ibosoftnet/efis/EEEN_102_Final_Report.pdf

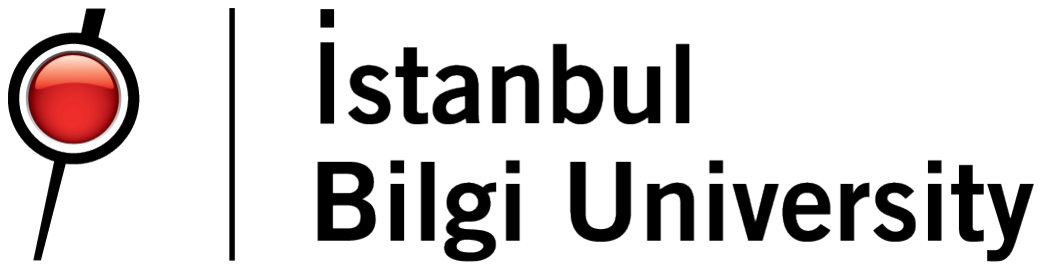
[picture p1: figure]

# Electronic Flight Instrument System (EFIS)

EEEN 102 Embedded Systems Programming Final Project

## İbrahim Çağlar YILDIRIM

June 19, 2024

## Contents

1 Introduction | 2
2 Air Data Unit Hardware | 3
2.3.2 Considerations Regarding the Design of the Circuit . . | 4
3 Air Data Unit MCU Software | 9
4 EFIS Display Software | 9
5 Abbreviations | 15
5.3.1 | ICAO Measurement Units and Quantity Symbols . . . . | 16
6 References | 17

1

## 1 Introduction

Main idea of the project is developing a fully real aviation compilant flight man-agament / navigation system and electronic flight instrument system (EFIS) for RC airplanes or UAVs. Because currently end user UAV flight controller kits are boring and they have missing features which used in real airplanes. Currently Air Data Unit and Display Software for ground station is developed. Radio navigation unit, flight management system and auto-flight systems will be developed in future.
This document includes these parts of project:
- Air Data Unit (v1.1)
- Air Data Unit MCU Software (v0.1)
- EFIS Display Software (v0.1.1)

All project files can be found at project’s GitHub page: https://github.com/ibosoftnet/efis

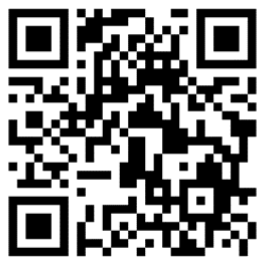
[picture p2: figure]

2

## 2 Air Data Unit Hardware

### 2.1 Introduction

Main hardware called as "Air Data Unit" and it reads sensor data and sends the calculated air data to UART output. Air Data Unit consists of a outer case and a electronic board.
Outer case consist of a case and cover, cover has required holes for allowing to making connections to electronic board.
Electronic board is holds all circuit elements and main MCU for operating the Air Data Unit.

### 2.2 Features and Limitations

- Supply voltage range: 7.5 – 25 V.
- High voltage protection by varistors.
- Low voltage protection by MCU brownout detection.
- Separated supply lines for board and external devices.
- Max 100 mA for main board and max 500 mA for external outputs.
- 100 mA PTC fuses on each power out.
- All I/O pins (except SPI) has serial current limiting resistors.
- ATMega 328P MCU @ 20 MHz
- RTC chip for date and time keeping.
- CR1220 battery for RTC chip.
- Separated I²C lines via switch for isolating lines from each other when corruption occurs on some of lines.
- Main UART for data transmission and secondary UART for GNSS mod-ule.
- UART1 can capable up to 230400 bauds and has flow control pins.
- UART2 can capable up to 38400 bauds.
- SPI port (6 pins AVR ISP).
- 6 configurable general purpose I/O or analog inputs.

3

### 2.3 Electronic Board

### 2.3.1 Circuit Schematic

1 2
X1

20MHz

C2

22pF
C1

22pF

C5

100nF

1 2

L1

~10-100uH

Ceramic

D1

1N4148 R1

10k | 2

1

4

3

SW1

TACH 6x6x4

R2

330

C14

100nF

D3

1N4148 D4

5.1V | R3
| 2.2k

PD0/RX
PD1/TX
PD2 PD3 PD4 PD5 PD6 PD7

PD0/RX

PD2

PULS RES | PULS RES

PC0/ADC0 PC1/ADC1 PC2/ADC2 PC3/ADC3 SDA

SCL

ADC6 ADC7

MISO
SCK
MOSI | SPI RES

AV BUS

PC0/ADC0

PC2/ADC2

ADC6

PB0 PB1

C4

100nF

1

1
2

2
3

3
4

### 4 J5

JST PH 4 PIN

1

1
2

2
3

3
4

### 4 J6

JST PH 4 PIN

1

1
2

2
3

3
4

### 4 J7

JST PH 4 PIN

2 | 1 2 3 4

1

3

### 4 J8

JST PH 4 PIN

1

1
2

2
3

3
4

### 4 J9

JST PH 4 PIN

1

1
2

2
3

3
4

### 4 J10

JST PH 4 PIN AV BUS

SDA

SCL

RESET 3

A0 1 | A1 2 | A2 21
GND | 12
SC0 | 5
SC1 | 7
SC2 | 9
SC3 | 11
SC4 | 14
SC5 | 16
SC6 | 18
SC7 | 20

SCL 22

SD0 | 4
SD1 | 6
SD2 | 8
SD3 | 10
SD4 | 13
SD5 | 15
SD6 | 17
SD7 | 19

SDA 23

VCC 24 U2

TCA9548APWR

+

1
- 2

B1

DS1092-15-B6P | 1 2
X2

32.768kHz

PB2

PB0 PB1

PB2 | RST 5 | SCLK 7

I/O 6

X1 | 2
X2 | 3
VCC1 8 | VCC2 1

U3

DS1302

PD6

R16

10k

R8

2.2k

D2

1N4148

RES

PB0/ICP1/CLKO/PCINT0 | 12 PB1/OC1A/PCINT1 | 13
PB3/MOSI/OC2A/PCINT3 | 15 PB2/SS/OC1B/PCINT2 | 14
PD6/AIN0/OC0A/PCINT22 10 | PD5/T1/OC0B/PCINT21 9 | PD4/T0/XCK/PCINT20 2 | PD3/INT1/OC2B/PCINT19 1 | PD2/INT0/PCINT18 32 | PD1/TXD/PCINT17 31 | PD0/RXD/PCINT16 30
PB4/MISO/PCINT4 | 16 PB5/SCK/PCINT5 | 17
PB7/TOSC2/XTAL2/PCINT7 | 8 PB6/TOSC1/XTAL1/PCINT6 | 7
PC6/RESET/PCINT14 | 29 PC5/ADC5/SCL/PCINT13 | 28 PC4/ADC4/SDA/PCINT12 | 27 PC3/ADC3/PCINT11 | 26 PC2/ADC2/PCINT10 | 25 PC1/ADC1/PCINT9 | 24 PC0/ADC0/PCINT8 | 23 AVCC 18 | AREF 20

PD7/AIN1/PCINT23 11

ADC6 19 ADC7 22

U1

ATMEGA328P

RES

RT3 +tc100mA | +tc

RT5

100mA +tc

RT6

100mA +tc

RT7

100mA +tc

RT8

100mA +tc

RT9

100mA +tc

RT10

100mA

VI 3 | VO | 1 GND

2

U4

78L05

C11

330nF | C12
| 100nF

D9

1N4007

D8

1N4007

VI 2 | VO | 3 GND

1

U5

7805 1 2

C10

47uF 25V

AV BUS

R10

2.2k

1 2
C13

47uF 16V

1

1

2

### 2 J12

JST XH 2 PIN

RT2 +tc500ma

1 2 U7:A

74HC14

R17

2.2k

D17

RED 3 mmR18

2.2k

D18

RED 3 mmR19

2.2k

D19

RED 3 mmR20

2.2k

D20

RED 3 mm

D15

RED 3 mmR22

2.2k

D16

RED 3 mm

PD0/RX 8 | 9 U6:F

74HC14
PD1/TX 10 | 11 U6:E

74HC14
PD2 4 | 3 U6:B

74HC14
PD3 6 | 5 U6:C

74HC14

PD4

PD5

4 3 U7:B

74HC14

8 9 U7:F

74HC14

10 11 U7:E

74HC14
12 13 U7:D
74HC14 | 2 1
VR2

25V

C15

100nF

C16

100nF

C7

330nF | C8
| 100nF

D7

1N4007

D6

1N4007 1 2
C6
22uF 25V | 1 2
C9

22uF 16V

1

1

2

### 2 J11

JST XH 2 PIN

RT1 +tc100mA | 2 1

VR1

25V

R4
100k | PD0/RX R5
100k | PD2

D5

1N4148 C3

100nF

RT4 +tc100mA

AV BUS

D11

GREEN 3 mm AV BUS

R9

2.2k

R29220 | R30220 R31220 | ADC7 R32220 R33220 | PC1/ADC1

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
JST PH 8 PIN

R34220 PC3/ADC3

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
JST PH 4 PIN

R23
220 R24220

PD1/TX R25

220 R26
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
JST PH 6 PIN

PD5

PD4 R27

220 R28

100k

6 5 U7:C

74HC14

R21

2.2k

2 1 U6:A

74HC14

12 13 U6:D

74HC14

C17

100nF

SCL

SDA

R6

2.2k R7

2.2k

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
IDC 2x3

MISO

SCK | MOSI SPI RES PD⁷

D10

YELLOW 3 mm

D12

GREEN 3 mm

Q1

BC857A

R11

2.2k

D13

RED 3 mm

Q2

BC857A

R14

2.2k

D14

RED 3 mm

R13

330

R12

100k SDA | SCL

R15

100k

IboSoft Air Data Unit v1.1
Web: www.ibosoft.net.tr
GitHub: ibosoftnet/EFIS

Figure 1: Circuit schematic

### 2.3.2 Considerations Regarding the Design of the Circuit

- All ICs have 100 nF ceramic de-coupling capacitors connected to supply pins.
- All communication line LEDs isolated from communication lines with NOT gates or BJT transistors for allowing the high speed communication.
- D7, D9, C7, C8, C11, C12 placed according to recommendations mentioned in various 78XX series linear voltage regulator datasheets.
- D6, and D8 prevents from reverse voltage with short circuiting and causing the trip of RT1 or RT2 PTCs.
- C6, C9, C10, C13 placed as bulk capacitor for preventing the supply voltages from dropping low during high peak loadings.
- D2 and D3 placed for protecting connected SPI device from short circuit when reset line goes low during reset output of SPI device is high.

4

- C14 placed for generating pulse reset signal for generating single reset if programmer pulls the reset pin of UART1 to low continuously.
- D3 diode prevents current wants to travel to MCU if UART1 reset line goes low and after high. Because voltage over C14 will increase in this situation. Normally, reset pin durable the higher voltages due to HVPP mode but other external devices connected to reset line may damaged if voltage exceeds the limit.
- D4, R3 and D5 placed to ensuring the discharge of C14. Otherwise, UART1 device can’t reset the MCU anymore after first reset attempt. R3 limits the discharge current for protecting the C14, D4, R3 and D5 from high peak current.
- All UART I/Os have required pull-up or pull down resistors.
- I

2C outputs haven’t got pull-up resistors because external I²C devices may have internal pull-up resistors and this may cause to excessively low equivalent pull-up resistances if pull-up resistors placed to I²C outputs. If a external I²C device hasn’t got internal pull-up resistors, external pull-up resistors must be connected to related output.

- RX and TX lines of UART2 passed through NOT gates for take advantage of inverted software serial method because it provides greater baud rates than non-inverted software serial.

Most applicable recommendations and limitations have been followed mentioned in Atmel AVR042: AVR Hardware Design Considerations guide and Microchip ATmega 328 datasheet:

- All outputs except SPI has current limiting resistors.
- All MCU supplies have 100 nF ceramic de-coupling capacitors.
- Low-pass filter created with L1 and C5 used for filtering the AVCC supply of MCU.
- R2 placed for limiting peak voltage induced by self-inductance of SW1 button.
- External pull-up resistor (R1) placed for guaranteeing high state at reset input.
- D1 placed for ESD protection because reset pin hasn’t got internal ESD protection diodes due tı HVPP mode of ATmega MCUs.
- 22 pF ceramic capacitors used for 20 MHz crystal.

5

### 2.3.3 PCB Design Rules

- SMD and TH mixed.
- 2 layers used.
- Minimum 9 Thou spacing and trace width used.
- Dimensions are 42 mm × 82 mm.
- Screw holes are M3.

### 2.3.4 Images of PCB

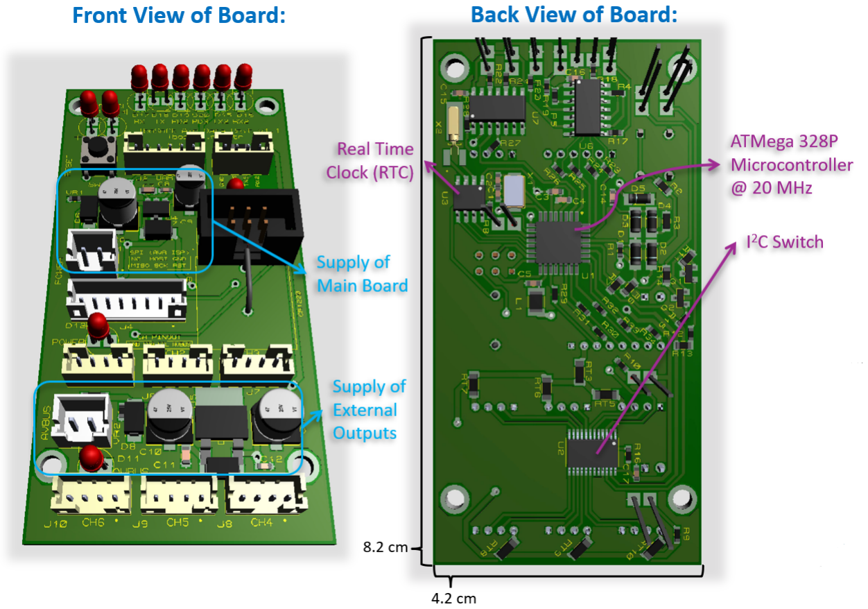
[picture p3: figure]

Figure 2: Front and back view of PCB

6

### 2.3.5 Block Diagram

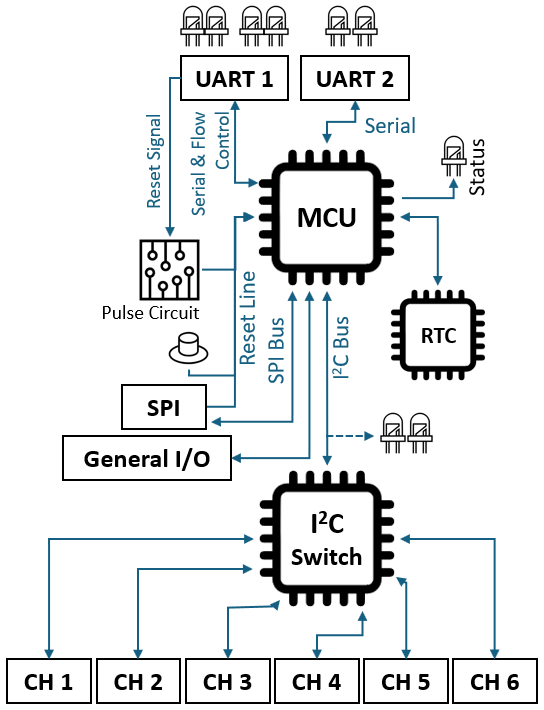
[picture p4: figure]

Figure 3: Block diagram of electronic board.

### 2.4 Entire Unit

### 2.4.1 Images of Unit

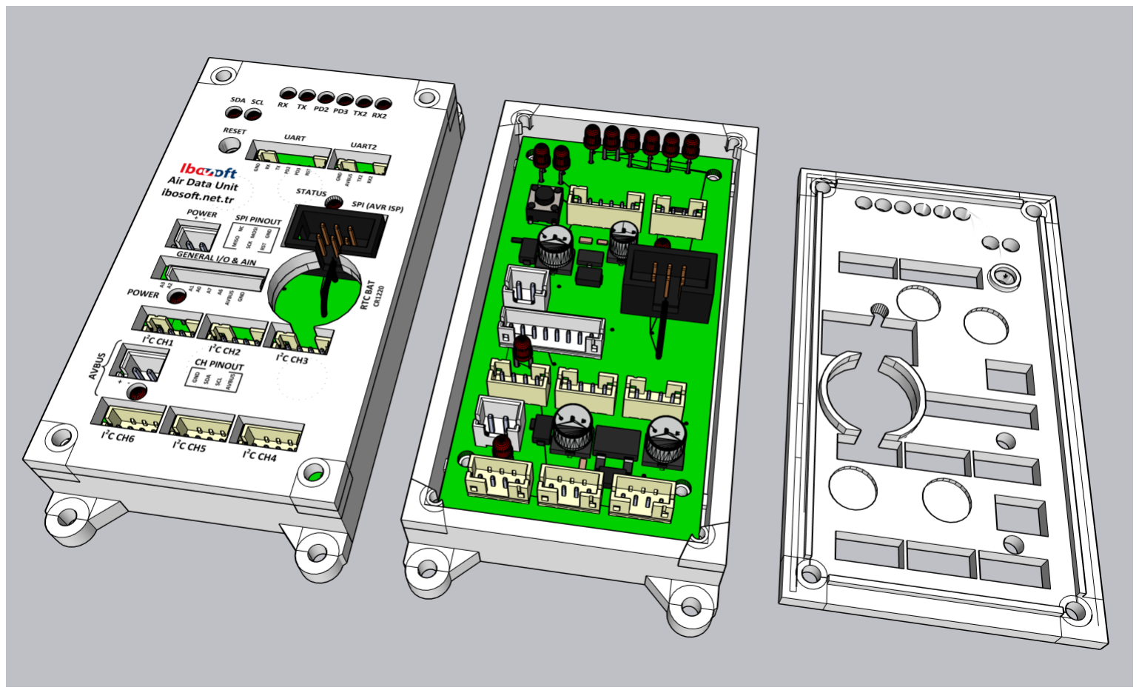
[picture p5: figure]

Figure 4: Images of inside and outside of case.

7

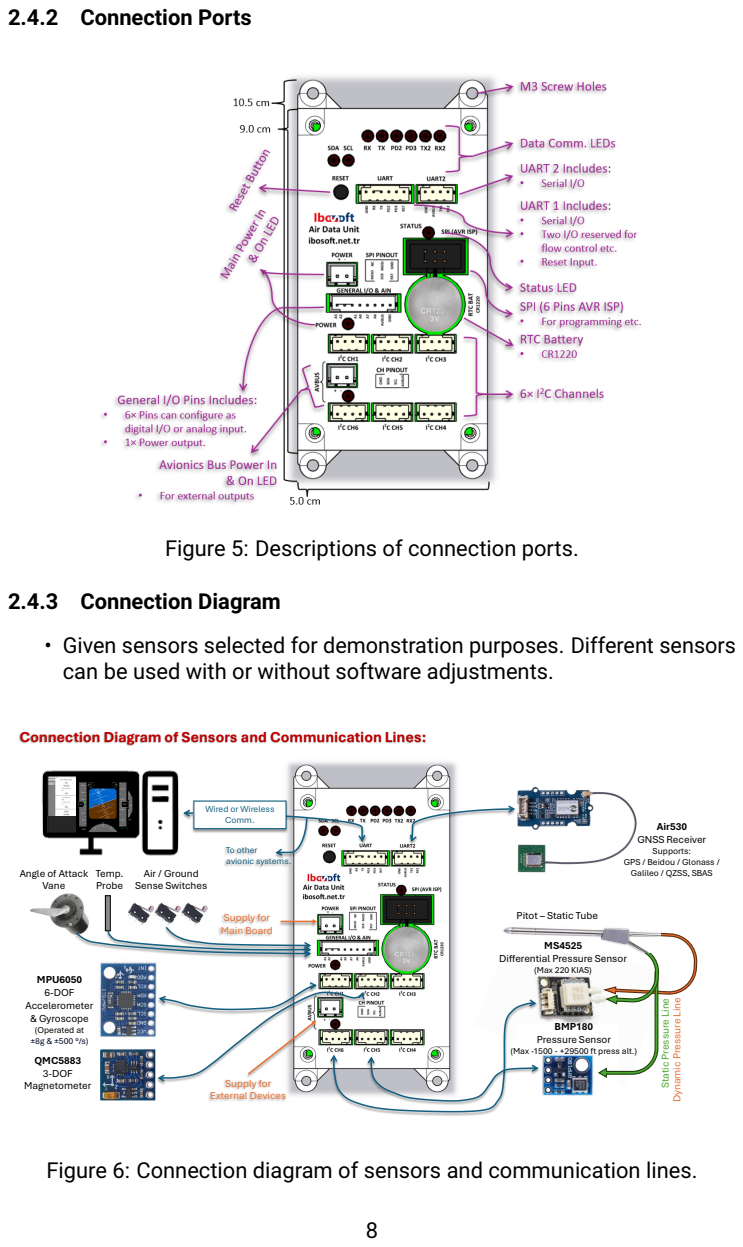
[picture p6: page 9]
2.4.2 Connection Ports; 2.4.3 Connection Diagram; Supply for Main Board; Supply for External Devices; Temp. Probe; Air / Ground Sense Switches; MPU6050 6-DOF Accelerometer & Gyroscope (Operated at ±8g & ±500 °/s) QMC5883 3-DOF Magnetometer; (Max 220 KIAS); To other avionic systems.

Figure 5: Descriptions of connection ports.

• Given sensors selected for demonstration purposes. Different sensors
can be used with or without software adjustments.

Connection Diagram of Sensors and Communication Lines:

Wired or Wireless
Comm.

Air530
GNSS Receiver
Supports:
GPS / Beidou / Glonass /
Galileo / QZSS, SBAS

Angle of Attack
Vane

Pitot – Static Tube

Differential Pressure Sensor

Static Pressure Line

Dynamic Pressure Line

BMP180
Pressure Sensor
(Max -1500 - +29500 ft press alt.)

Figure 6: Connection diagram of sensors and communication lines.

## 3 Air Data Unit MCU Software

Air Data Unit MCU Software reads sensor data and calculates usable air data according to raw sensor datas and send them over UART1 serial output. GNSS data reading and parsing will be integrated in future. Air data calculation derived from ICAO Doc 7488 - Manual of The ICAO Standard Atmosphere but detailed air data calculations and software features don’t shown in this document.
C/C++ programming language used with AVR-GCC compiler. Main aim is avoiding excessive library use but we couldn’t avoid using Arduino libraries because it required by some other libraries. We will eliminate the use of some libraries in the future.
An external header file that stores only the variables was created so that adjustments could be made without editing the main code.

## 4 EFIS Display Software

### 4.1 Introduction

EFIS Display Software used for displaying air data and sending commands to Air Data Unit via serial port. Python programming language was used. Display software decodes incoming serial data and shows air data symbology according to incoming data and it capable to show failure flags for related air data if sensor failure sended in incoming data. Also Display Software can capable to detect communication lost. Currently, only primary flight display (PFD) completed, other displays will be developed in future.
Also it provides a control menu for adjusting some settings and sends to changed data to Air Data Unit in every data cycle. "Tkinter" library used for control menu.
Symbology displaying with "Pygame" library. Some symbologies are code-based, while others are created by projecting image files onto the screen. Mathematical algorithms used for positioning the symbols doesn’t explained in this document.
Boeing-style symbology was used due to familiarity. Symbologies derived from PDF formatted Boeing 737 Flight Crew Operation Manual (FCOM). As font, original Boeing font didn’t use due to copyright issues so OCR-B font selected for displaying texts and numbers.

9

### 4.2 PFD - Normal Symbology

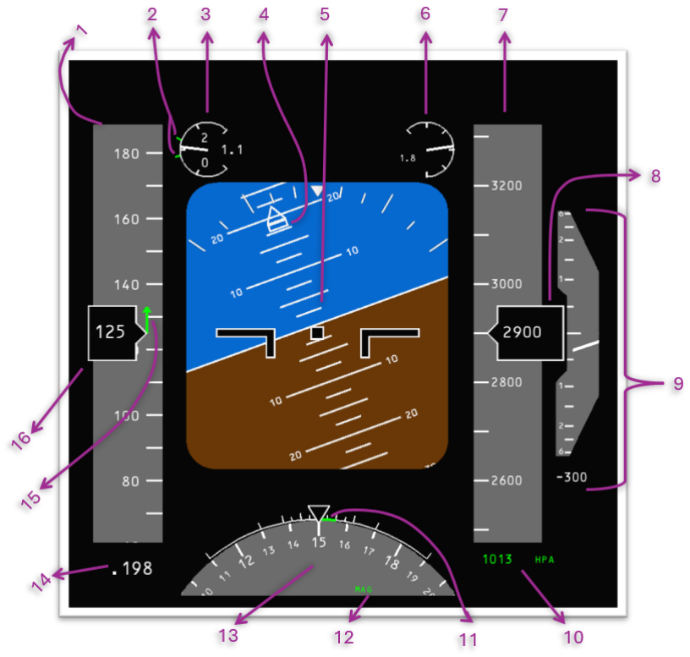
[picture p7: figure]

Figure 7: Descriptions of PFD symbology.

1. Airspeed Tape.
2. G Peaks (g): Shows minimum and maximum recorded vertical acceleration in g. Can be resetten from "G Peaks" page.
3. Vertical Acceleration Indicator: Shows vertical acceleration in g.
4. Slip / Skid Indicator: Shows lateral acceleration.
5. Attitude Indicator: Shows pitch and roll angles in degrees (°). Ticks over roll scale are equal to these values in order of: 10°, 20°, 30°, 45°, 60°.
6. Angle of Attack Indicator: Shows angle of attck in degrees (°). Single division is equal to 10°.

10

7. Altitude Tape.
8. Altitude Indicator: Shows barometric altitude in foot (ft).
9. Vertical Speed Indicator: Shows barometric vertical speed in foot per minute (ft/min).
10. Altimeter Setting Indications: Shows altimeter setting mode and value:
(a) STD (Green): Standart altimeter setting (1013.25 hPa) selected after climbed above transition altitude.
(b) STD (Amber): Standart altimeter setting (1013.25 hPa) still selected after descending below transition level.
(c) xxx HPA (Green) or xxxx HPA (Green): Altimeter setting value set unit of hectopascal (hPa) before climbing above transition altitude or after descended below transition level.
(d) xxx HPA (Amber) or xxxx HPA (Amber): Altimeter setting value set unit of hectopascal (hPa) after climbed above transition altitude or before descending below transition level.
(e) xx.xx IN (Green): Altimeter setting value set unit of inch of mercury (inHg) before climbing above transition altitude or after descended below transition level.
(f) xx.xx IN (Amber): Altimeter setting value set unit of inch of mercury (inHg) after climbed above transition altitude or before descending below transition level.
11. Turn Rate Indication: Shows horizontal turn rate in degrees per second (°/s). Ticks are equal to these values in order of: 1.5 °/s, 3 °/s, 4.5 °/s, 6 °/s, 10 °/s, 20 °/s.
12. Compass Mode Annunciation: Indicates operation mode of compass:
(a) MAG (Green): Compass is in tilt-compensation mode and shows magnetic heading.
(b) TRU (Green): Compass is in tilt-compensation and shows true heading.
(c) UNCORR MAG (Amber): Compass is not in tilt-compensation mode and shows magnetic heading.
(d) UNCORR TRU (Amber): Compass is not in tilt-compensation mode and shows true heading.
13. Compass.
14. Mach Indicator: Shows mach number. Displaying over 0.1 mach.

11

15. Speed Trend Arrow: Shows acceleration in aircraft’s movement axis.
16. Airspeed Indicator: Shows Indicated airspeed in knot (kt).

12

### 4.3 PFD - Failure Flags

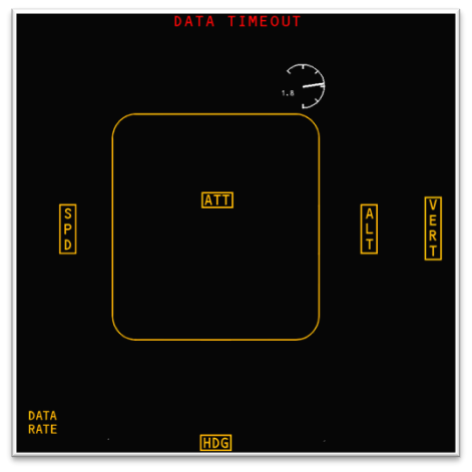
[picture p8: figure]

Figure 8: PFD failure flags.

Red flags depented to Display Software. Amber flags send by Air Data Unit.

1. DATA TIMEOUT (Red): Incoming data not available. All shown data freezes.
2. DATA RATE (Amber): Air Data Unit single measurement cycle exceeds the adjusted limit.
3. SPD (Amber): Differential pressure sensor malfunction. Removes airspeed indicator and airspeed tape, mach indicator.
4. ATT: Inertial Measurement Unit (IMU) malfunction. Removes:

13

(a) Attitude indicator.
(b) Slip / Skid Indicator.
(c) Vertical Acceleration Indicator.
(d) Speed Trend Arrow.
(e) Turn Rate Indication.
(f) Reverts the compass mode to UNCORR MAG or UNCORR TRU automatically according to MAG or TRU selected.
5. ALT: Pressure sensor malfunction. Removes altitude indicator, altitude tape, altimeter setting indications.
6. VERT: vertical speed not available. Removes vertical speed indications
7. HDG: Magnetometer malfunction. Removes compass indications.

### 4.4 Control Menu

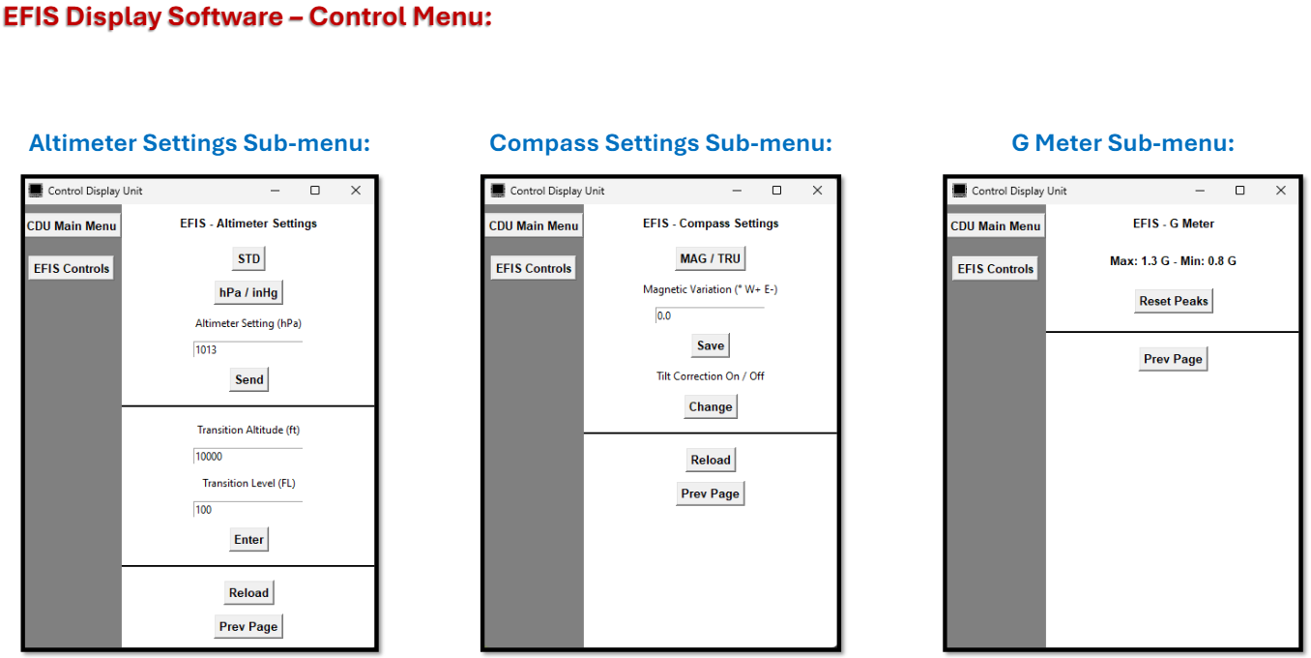
[picture p9: figure]

Figure 9: Menu pages of Control Menu

Detailed features currently don’t shown in this document.

14

## 5 Abbreviations

### 5.1 Electrical-Electronics Engineering

- AVR - Alf and Vegard’s RISC Processor
- CH - Channel
- ESD - Electronic Discharge
- GCC - GNU Compiler Collection
- HVPP - High-Voltage/Parallel Programming
- I/O - Input/Output
- I

2C - Inter-Integrated Circuit

- ISP - In-system Programming
- MCU - Microcontroller Unit
- PTC - Positive Temperature Coefficient
- PCB - Printed Circuit Board
- RC - Radio-controlled
- RTC - Real-time Clock
- RX - Receiver
- SMD - Surface Mount Device
- SPI - Serial Peripheral Interface
- TH - Through Hole
- TX - Transmitter
- UART - Universal Asynchronous Receiver/Transmitter

### 5.2 International System of Units (SI) For Engineering

- ° - degree
- m - meter
- cm - centimeter
- mm - millimeter

15

- nF - nanofarad
- pF - picofarad
- A - ampere
- mA - milliampere
- V - volt

### 5.3 Aviation

### 5.3.1 ICAO Measurement Units and Quantity Symbols

- ° - degree
- g - Local Acceleration of Free Fall
- hPA - hectopascal
- ft - foot
- kt - knot
- m - metre
- min - minute
- s - second

### 5.3.2 ICAO Doc 8400 Abbreviations

- EFIS - Electronic Flight Instrument System
- ICAO - International Civil Aviation Organization
- GLONASS - Global Orbiting Navigation Satellite System
- GNSS - Global Navigation Satelite System
- GPS - Global Positioning System
- SBAS - Satellite-based Augmentation System

### 5.3.3 Other Abbreviations

- inHg - inch of mercury
- PFD - Primary Flight Display
- UAV - Unmanned Aerial Vehicle

16

## 6 References

- NIST Special Publication 330 - The International System of units (SI), 2019 Edition
- Atmel AVR042 - AVR Hardware Design Considerations, Revision 2521K-AVR-03/11, 2011
- Microchip ATmega 48A/PA/88A/PA/168A/PA/328/P megaAVR Data Sheet, DS40002061A, 2018
- ICAO Annex 5 - Units of Measurement to be Used in Air and Ground Operations, 5th Edition Amendment 17, July 2010
- ICAO Doc 7488 - Manual of The ICAO Standard Atmosphere, 3rd Edition, 1993
- ICAO Doc 8400 - PANS Abbreviations And Codes, 9th Edition Amendment 33, 8 November 2018
- Boeing 737-600/-700/-800/-900/-900ER Flight Crew Operation Manual (FCOM) The Boeing Company (TBC), Revision 26, 25 March 2010

17
