ibosoftnet/efis/Box/Cover Texts.pdf

SDA SCL | RX TX PD2 PD3 TX2 RX2
RESET | UART | UART2

STATUS
SPI (AVR ISP)

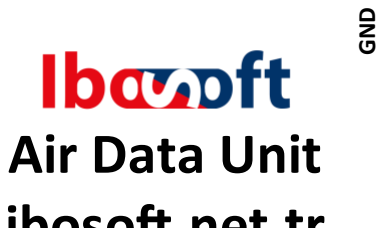
[picture p10: figure]
Air Data Unit

POWER

AVBUS

POWER

RTC BAT
CR1220

I

2
C CH1 | I

2
C CH2 | I

2
C CH3

I

2
C CH6 | I

2
C CH5 | I

2
C CH4

GENERAL I/O & AIN

+ -

+ -

GND
AVBUS
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
AVBUS

GND

GND
SDA
SCL

AVBUS

CH PINOUT

NC

MOSI
GND
SPI PINOUT MISO | SCK | RST

## ibosoft.net.tr

GND

RX

TX
PD2
PD3

RST
