ibosoftnet/efis/Box/Both Cover Opened and Closed.png

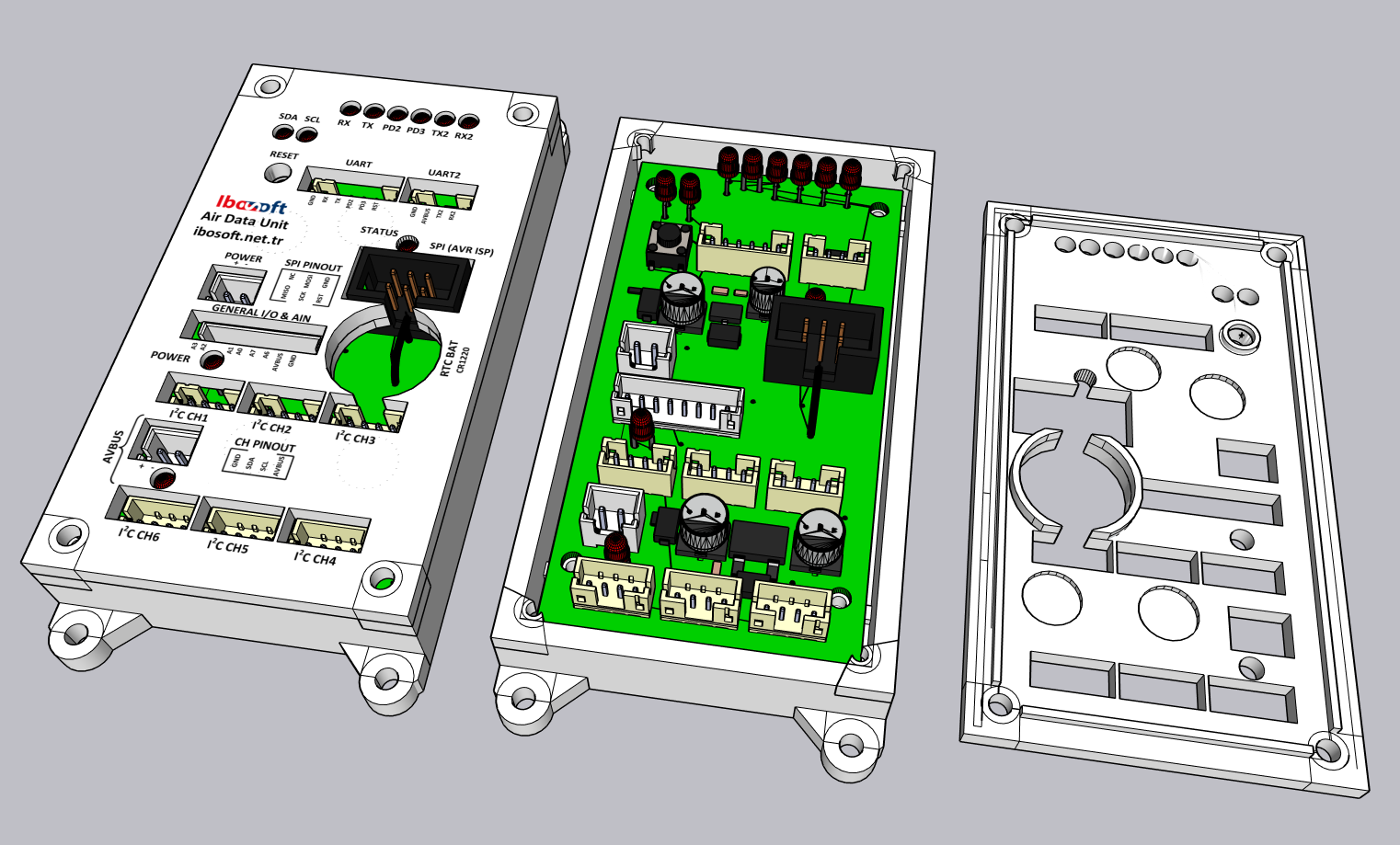
Box/Both Cover Opened and Closed.png
