ibosoftnet/efis/Box/Cover Texts.png

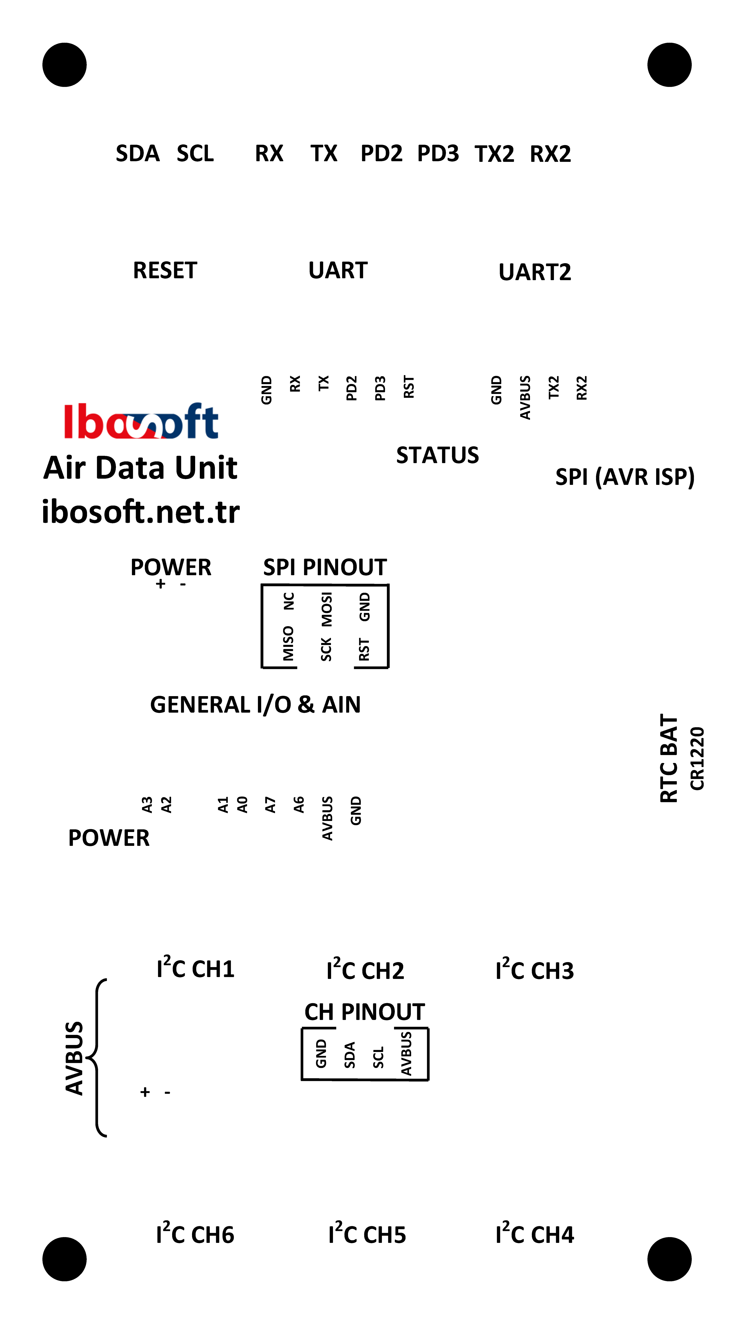
Box/Cover Texts.png
