ibosoftnet/efis/Box/Top View.png

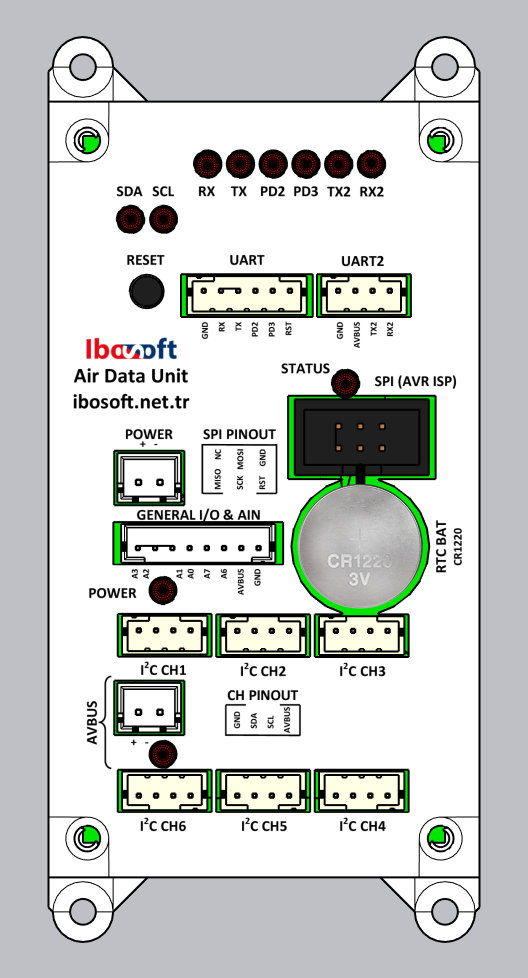
Box/Top View.png
