ibosoftnet/efis/Display Software/pfd_flags/pfd_flag_att_border.png

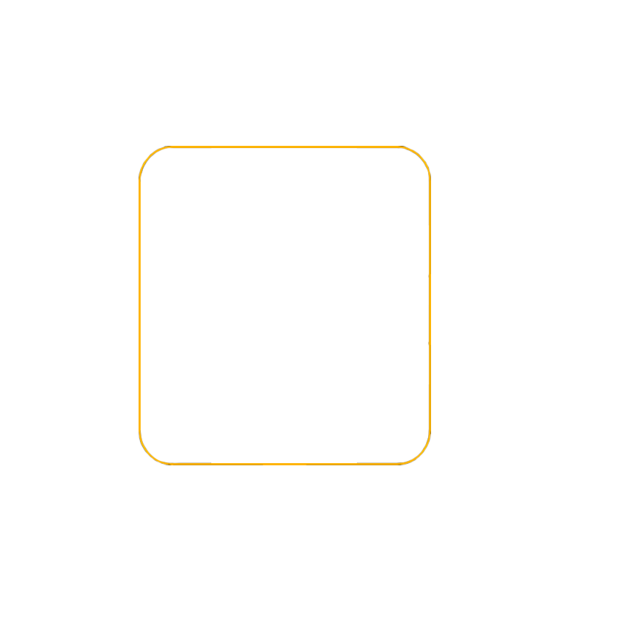
Display Software/pfd_flags/pfd_flag_att_border.png
