ibosoftnet/efis/Display Software/pfd_symbology/pfd_att.png

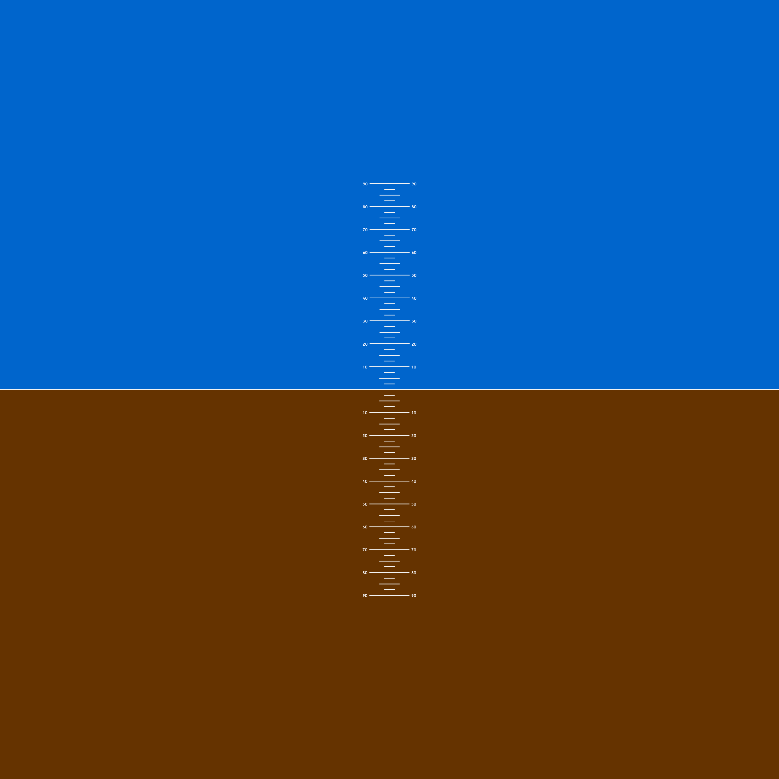
Display Software/pfd_symbology/pfd_att.png
