ibosoftnet/efis/Display Software/pfd_symbology/pfd_att_roll_scale.png

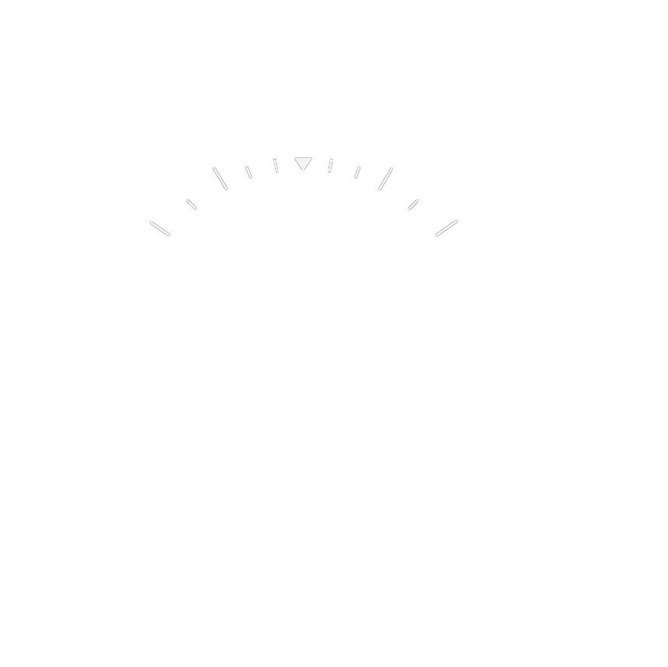
Display Software/pfd_symbology/pfd_att_roll_scale.png
