ibosoftnet/efis/Display Software/pfd_symbology/pfd_att_split_axis_pointer.png

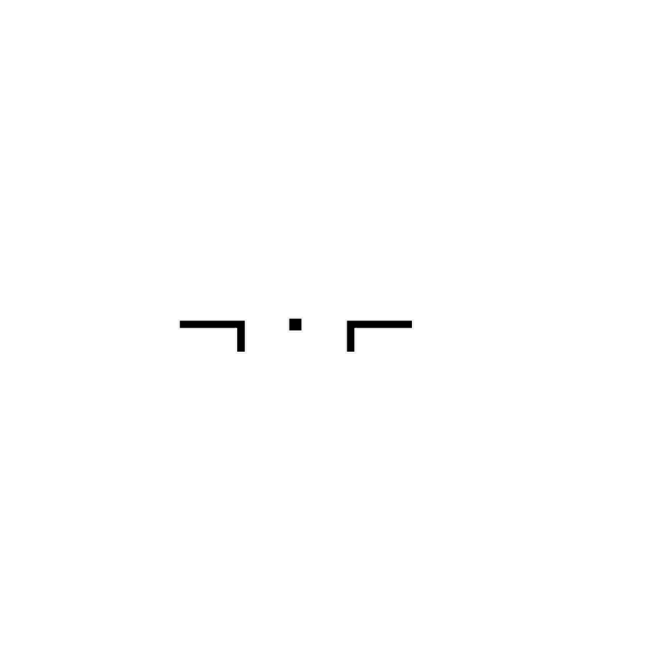
Display Software/pfd_symbology/pfd_att_split_axis_pointer.png
