ibosoftnet/efis/Display Software/pfd_symbology/pfd_background.png

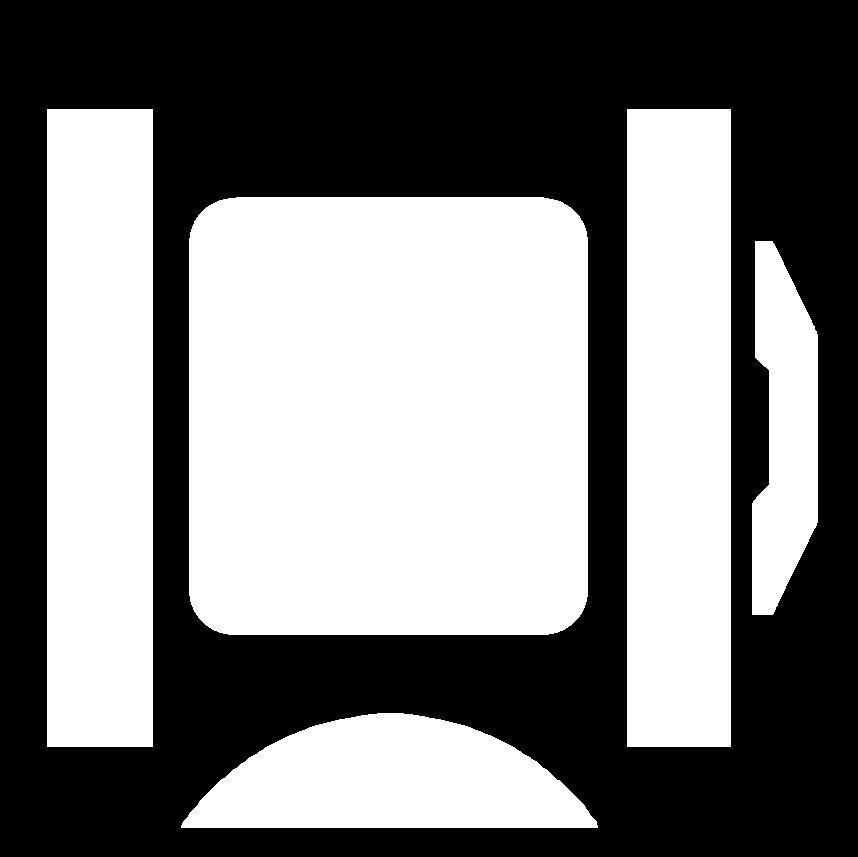
Display Software/pfd_symbology/pfd_background.png
