ibosoftnet/efis/Box/Cover Seperate.stl

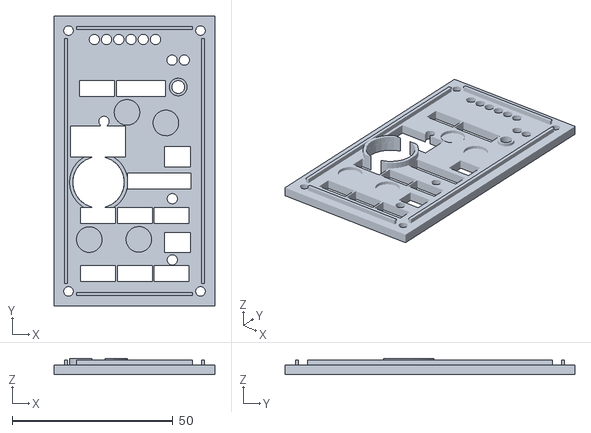
[picture p19: CAD file, 2024-05-29]
Box/Cover Seperate.stl
50.0 x 90.0 x 5.00
