ibosoftnet/efis/Electronic Board/3D Model/Air Data Unit v1.1.stl

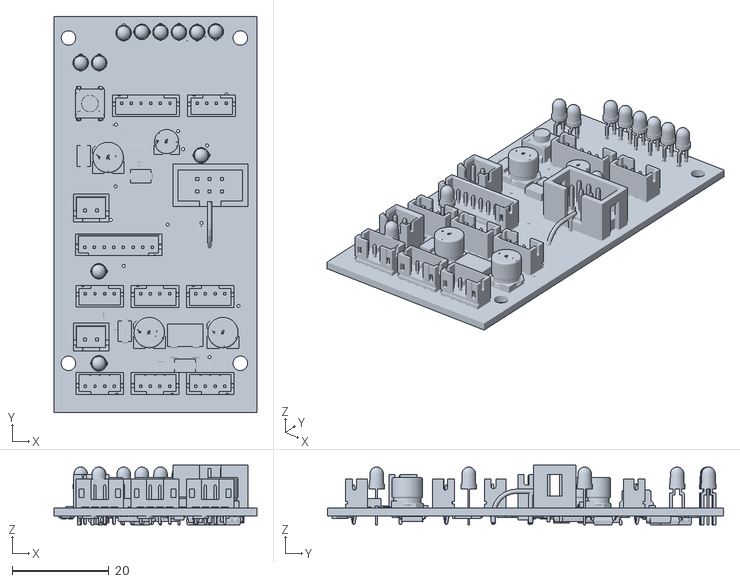
[picture p20: CAD file, 2024-05-17]
Electronic Board/3D Model/Air Data Unit v1.1.stl
42.0 x 82.0 x 12.4
