ibosoftnet/efis/Box/Case Seperate.stl

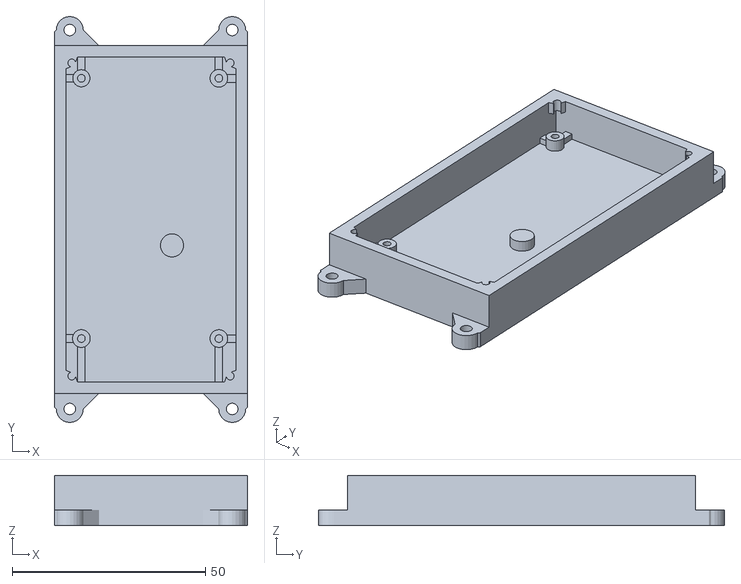
[picture p21: CAD file, 2024-05-29]
Box/Case Seperate.stl
50.0 x 105.0 x 13.0
