ibosoftnet/efis/Electronic Board/Schematic v1.1.PDF

## 4 J5

## 4 J6

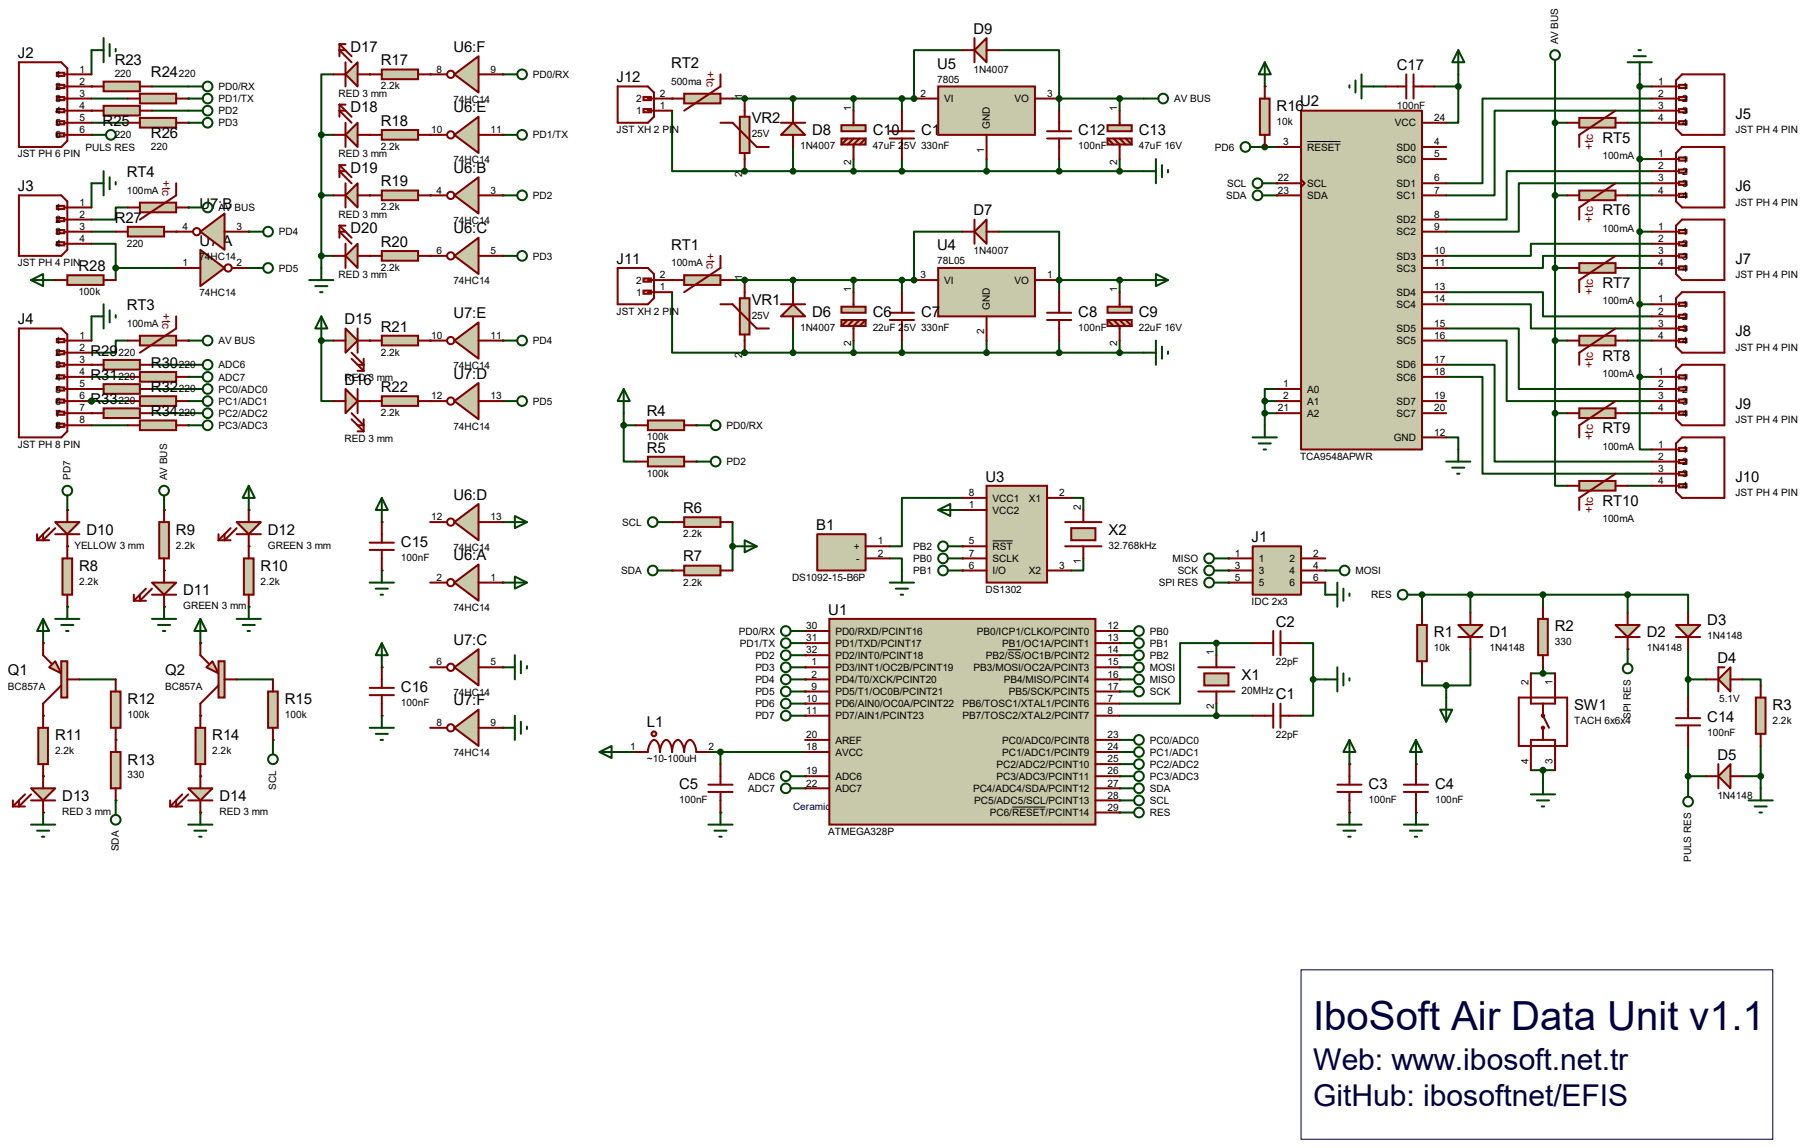
[picture p22: page 1]

JST PH 4 PIN AV BUS

GREEN 3 mm AV BUS

IboSoft Air Data Unit v1.1
Web: www.ibosoft.net.tr
GitHub: ibosoftnet/EFIS
