ibosoftnet/efis/Electronic Board/Air Data Unit v1.1.PDF

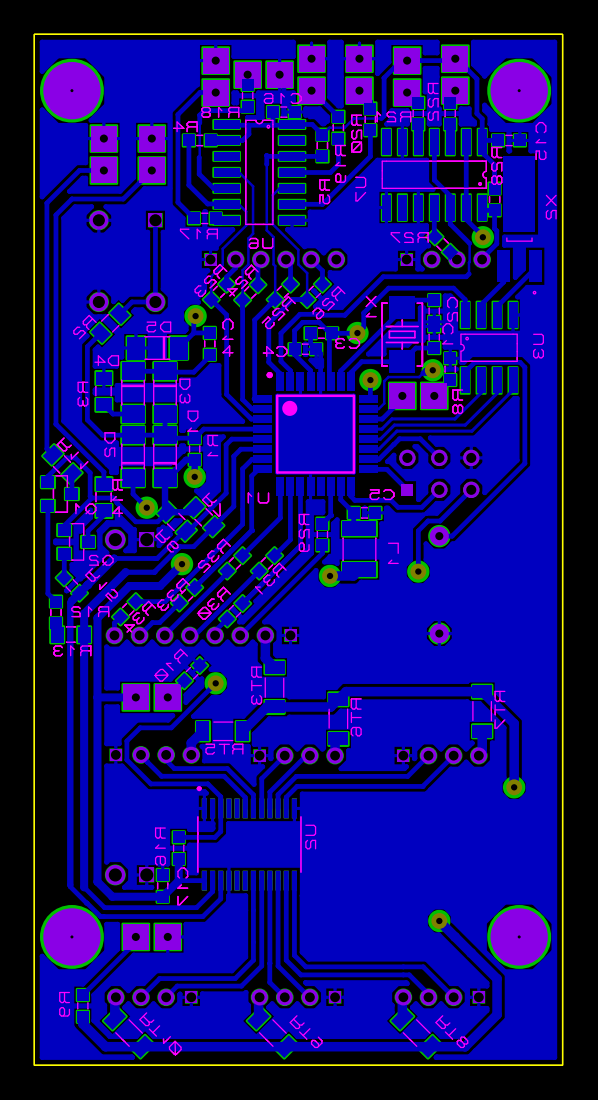
[picture p23: page 1]
