ibosoftnet/efis/Electronic Board/PCB Design/PCB Black Seperate Pages v1.1.PDF

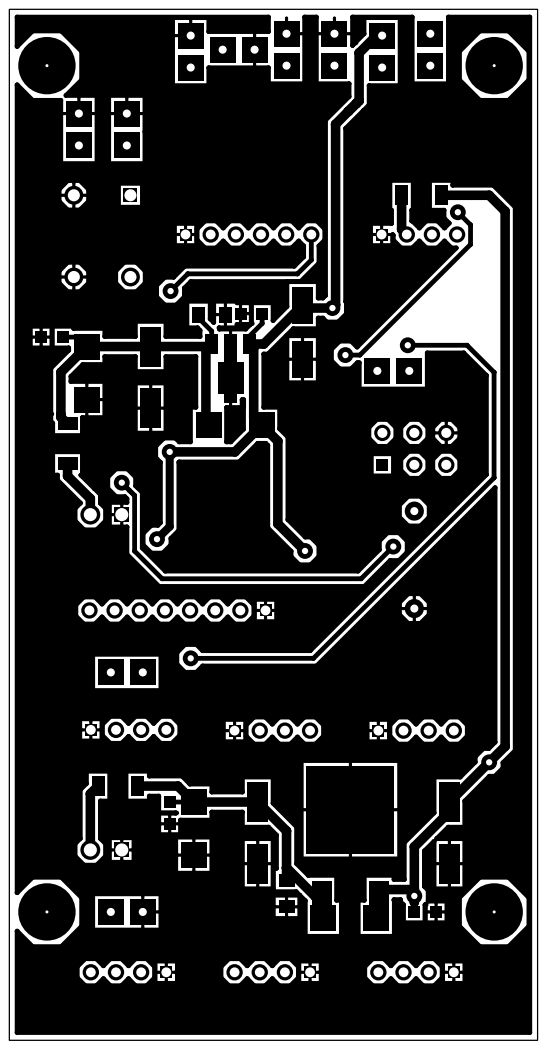
[picture p24: page 1]

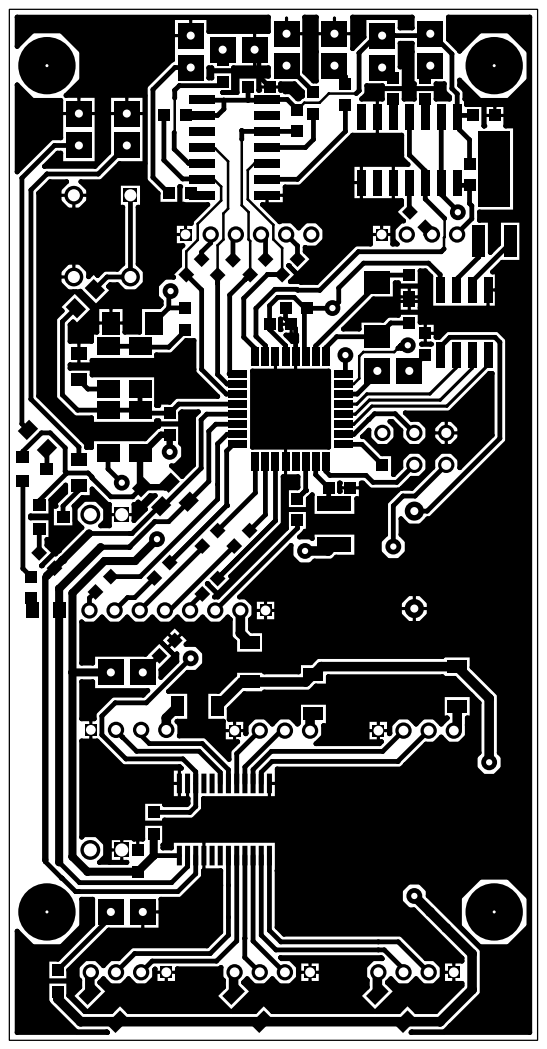
[picture p25: page 2]

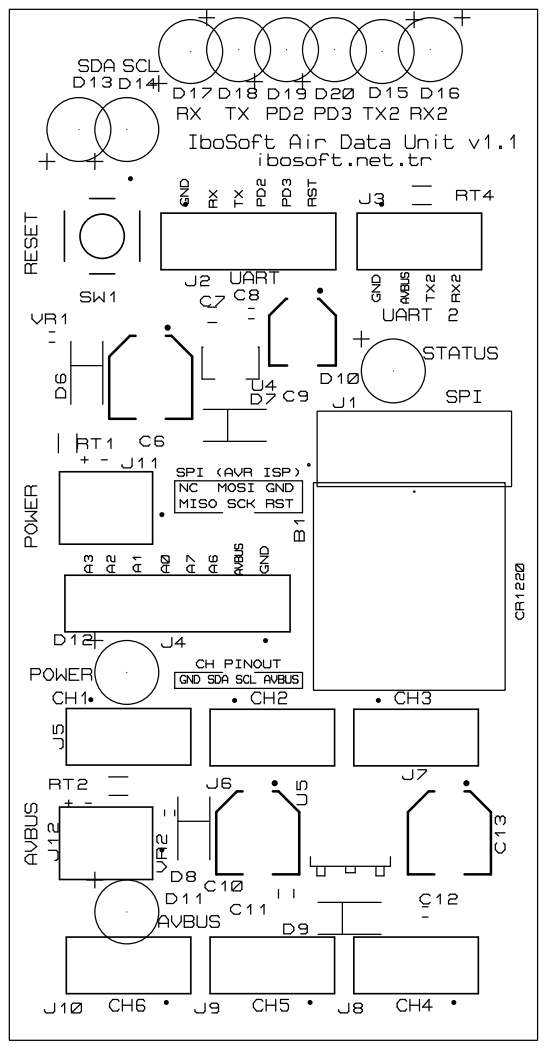
[picture p26: page 3]

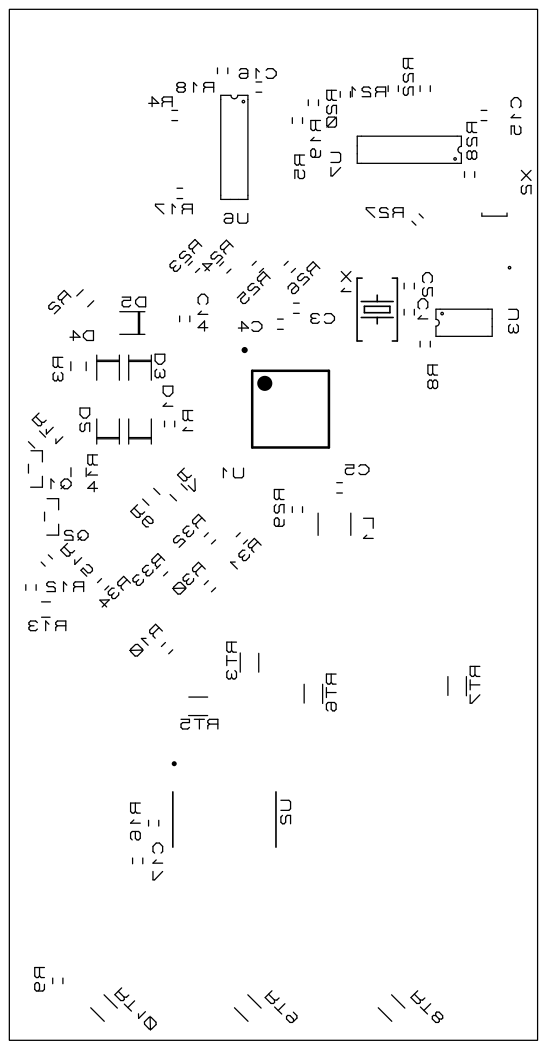
[picture p27: page 4]

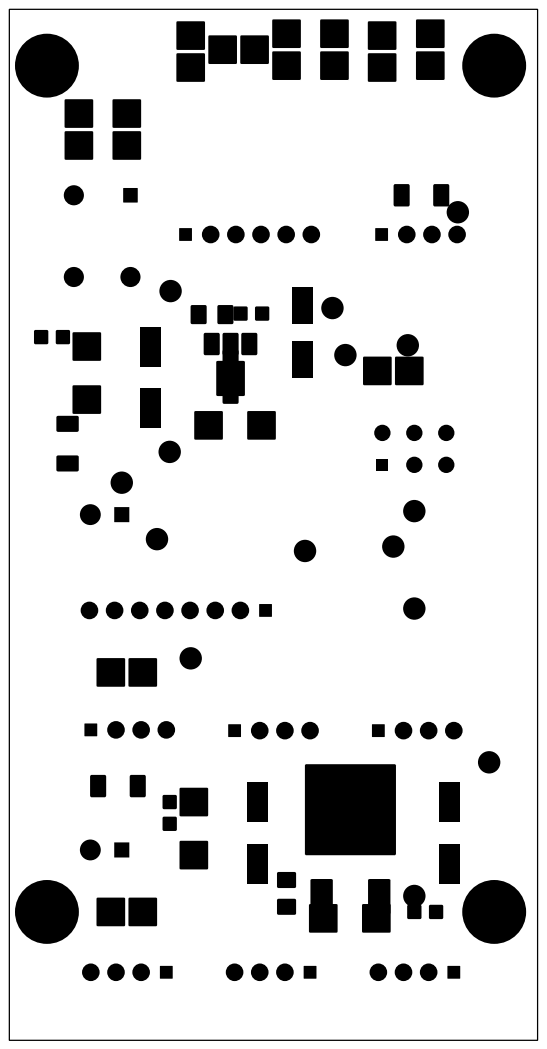
[picture p28: page 5]

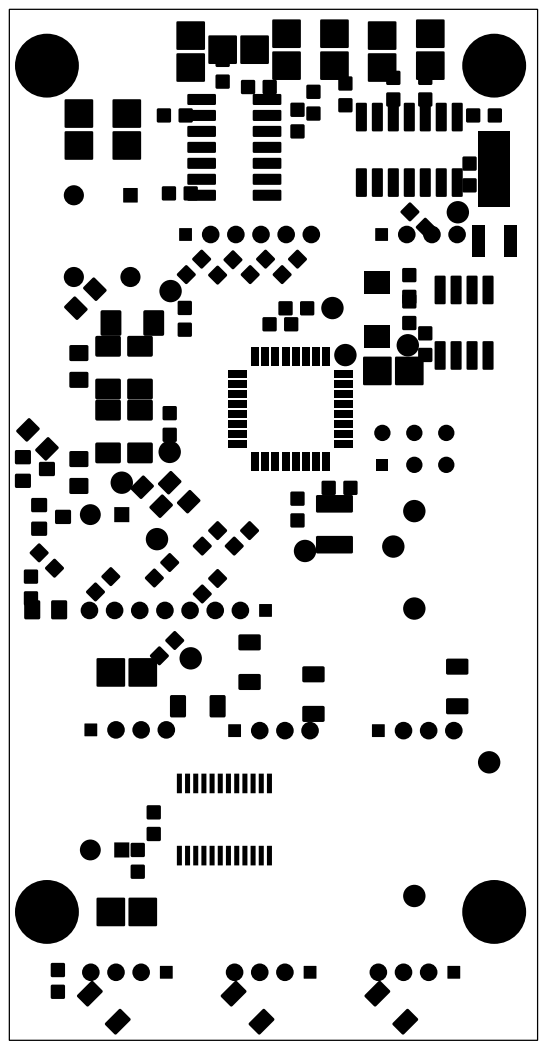
[picture p29: page 6]

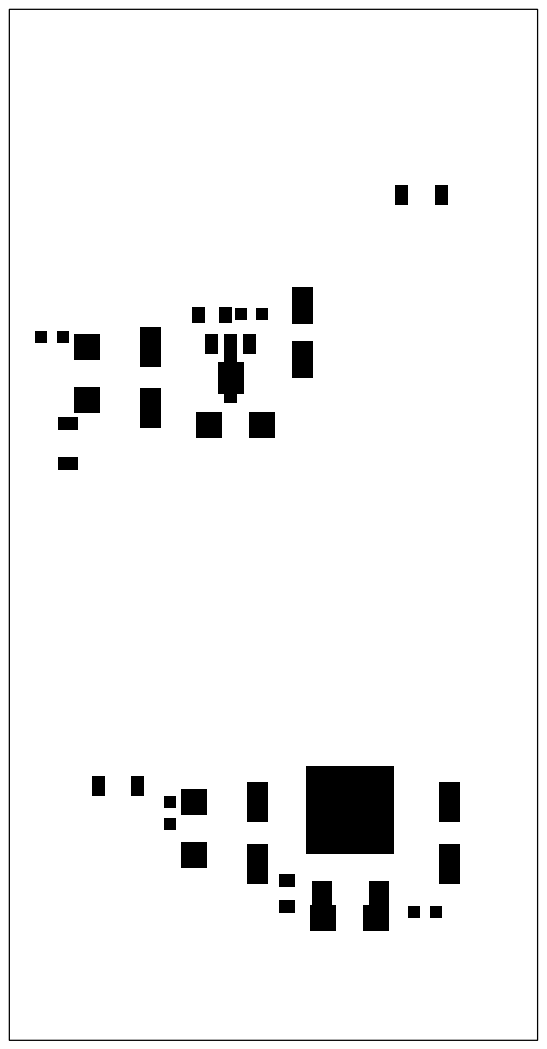
[picture p30: page 7]

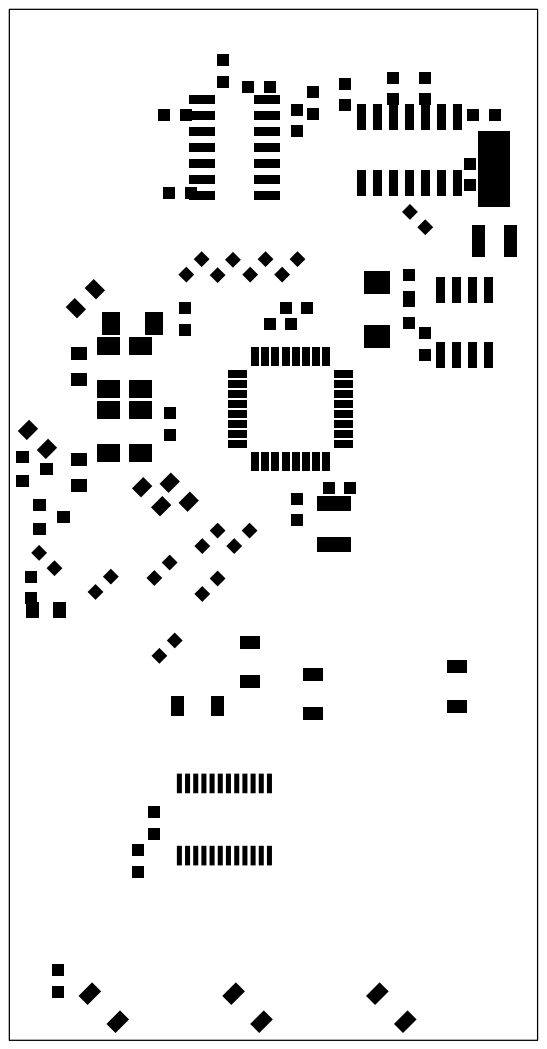
[picture p31: page 8]
