ibosoftnet/efis/Electronic Board/PCB Design/PCB Colored v1.1.PDF

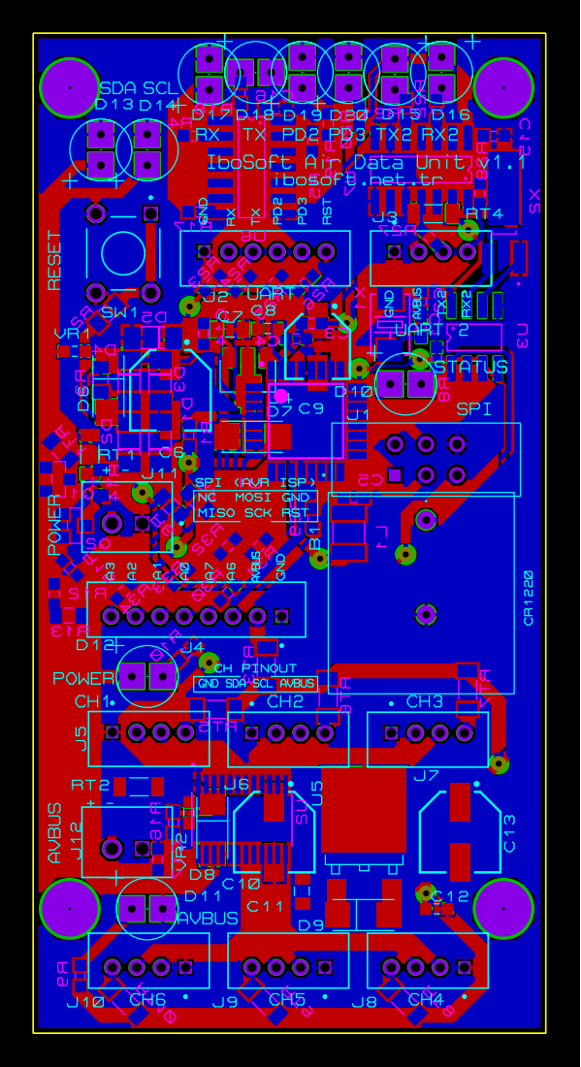
[picture p32: page 1]

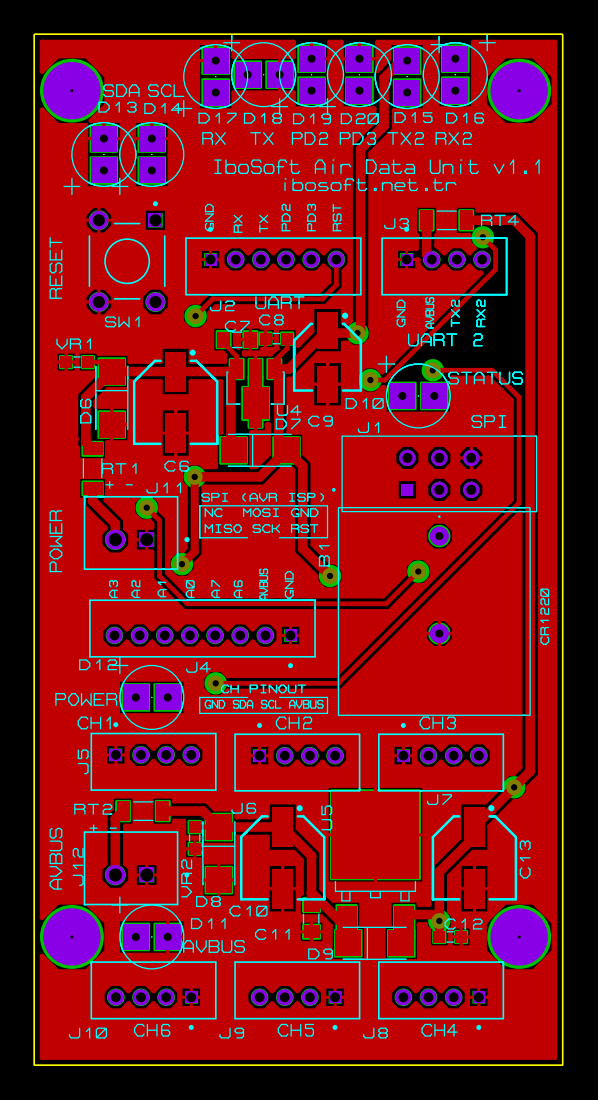
[picture p33: page 2]
