ibosoftnet/efis/(list of files, drawings)

Other design files:
Electronic Board/Air Data Unit v1.1.pdsprj
