ibosoftnet/efis/(commit log)

2024-04-06 irtifa değeri ft olacak şejilde düzeltilfi mag iyileştirildi ama hala oynak imu halloldu bir şekil i2c hızı 400 khz ye çekildi
2024-04-07 Some improvements. IMU fixed. Baro Vspd added.
    [main.cpp]
2024-04-07 Some adjustment made for IMU registers
2024-04-09 Serial port data namings shortened. Serial port reading function fixed.
    [main.cpp]
2024-04-10 Update main.cpp
    Magentometer formula changed.
    Gyro data start variable is corrected.
    [main.cpp]
2024-04-10 Magnetometer data reading sequence is corrected. Turn rate roll correction changed.
    [main.cpp]
2024-04-11 Update main.cpp
    Aoa max min values not printing anymore.
2024-05-03 PCB Drawing nearly completed
    [EFIS.pdsprj]
2024-05-04 PCB çizimi tamamlandı.
    [EFIS Project - CADCAM Bottom Assembly.GBR, EFIS Project - CADCAM Bottom Copper.GBR, EFIS Project - CADCAM Bottom SMT Paste.GBR, EFIS Project - CADCAM Bottom Silk Screen.GBR, EFIS Project - CADCAM Bottom Solder Resist.GBR, EFIS Project - CADCAM Drill TOP-BOT Filled and Plated.GBR, EFIS Project - CADCAM Drill TOP-BOT Plated.GBR, EFIS Project - CADCAM Profile.GBR]
2024-05-05 Box 3D model completed.
    [EFIS Project.dwg]
2024-05-07 STL files added for 3D printing.
    [Case Seperate.stl, Cover Seperate.stl]
2024-05-09 Added board images.
2024-05-15 MCU software adjusted for circuit board.
2024-05-17 Electronics Board Upgraded to v1.1
    New version released:
    + Some unwanted 90 deg traces corrected.
    + Pinout and PCB location of U5 corrected.
    + Silk texts corrected and added pinouts.
    [Air Data Unit v1.1.pdsprj, Air Data Unit v1.1.stl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]
2024-05-17 Small fixes
    Small fixes
    [Air Data Unit v1.1.pdsprj]
2024-05-29 3D model updated.
    [Case Seperate.stl, Cover Seperate.stl]
